Sihame-health/ECG-Holter-Prototype/hardware/p33_schema_circuit_pied_droit.png

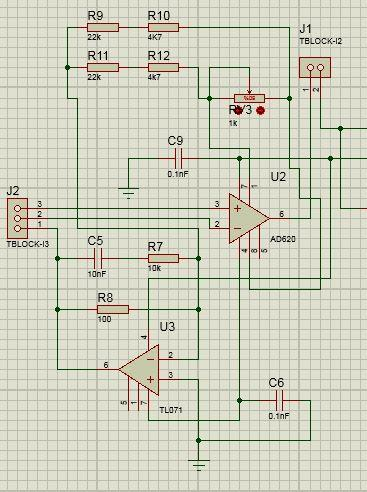
hardware/p33_schema_circuit_pied_droit.png
