Sihame-health/ECG-Holter-Prototype/hardware/p44_test_pc_smartphone_serial_monitor.png

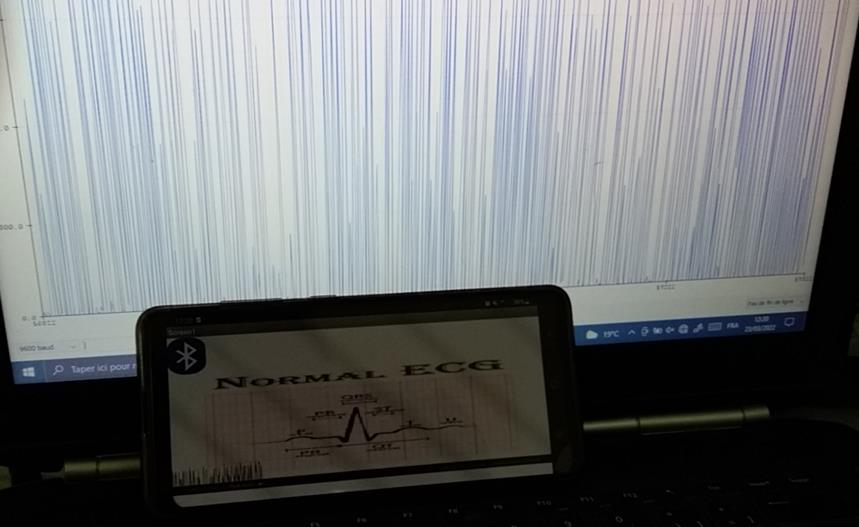
hardware/p44_test_pc_smartphone_serial_monitor.png
