Sihame-health/ECG-Holter-Prototype/hardware/p39_capture_smartphone_application.png

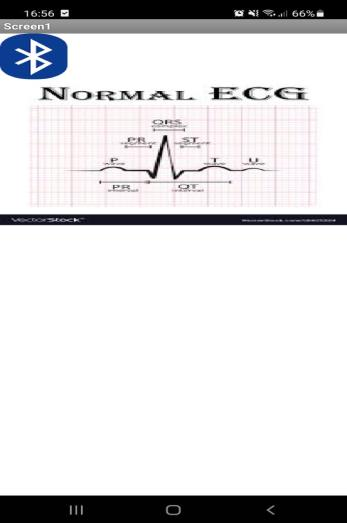
hardware/p39_capture_smartphone_application.png
