Sihame-health/ECG-Holter-Prototype/hardware/p40_pcb_typon.png

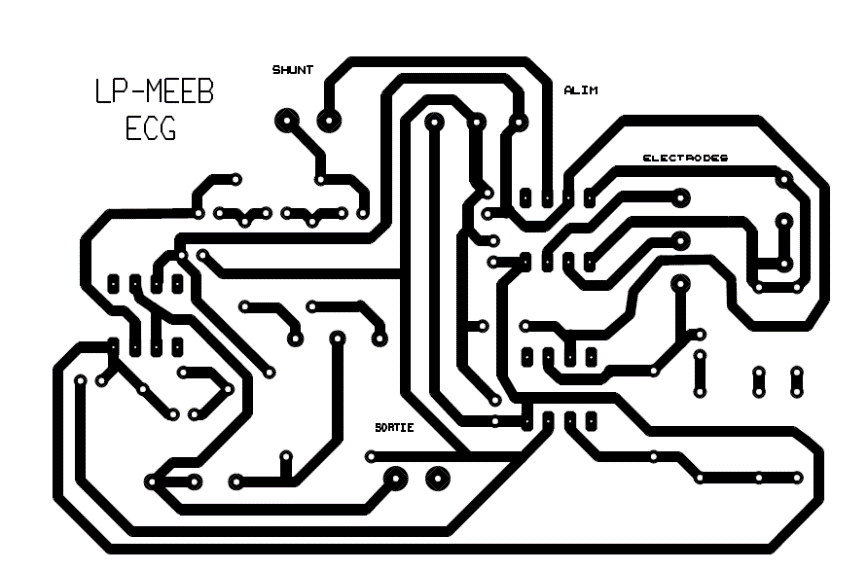
hardware/p40_pcb_typon.png
