Sihame-health/ECG-Holter-Prototype/hardware/p43_mesure_oscillo_ecg_carte.png

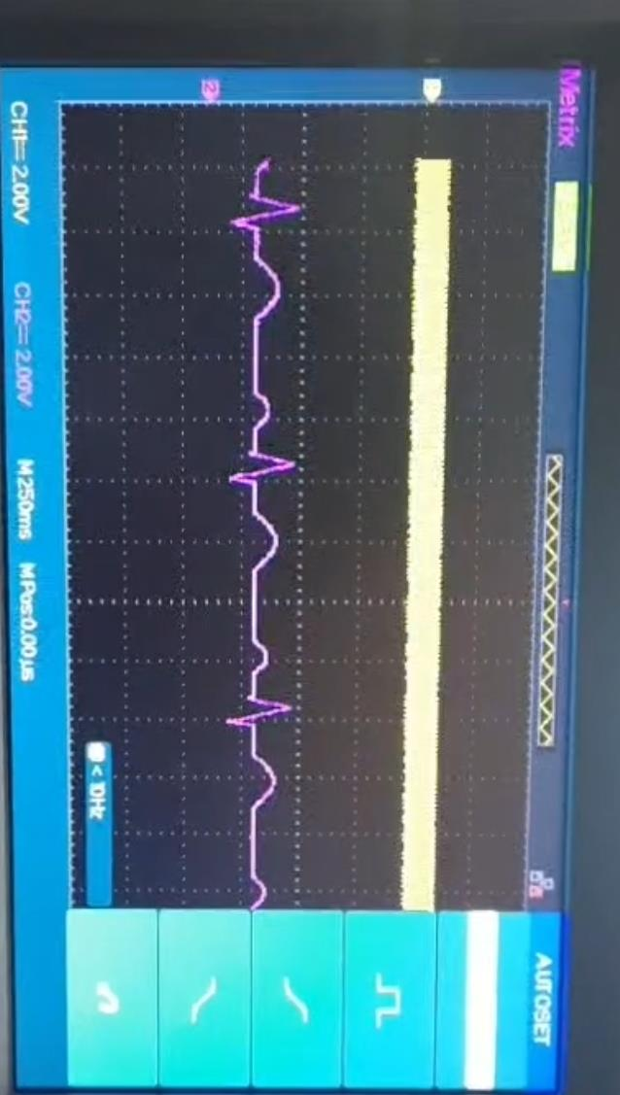
hardware/p43_mesure_oscillo_ecg_carte.png
